midarubiccube/homemade_NIC/自作NICキット説明書.pdf

# 自作NICキット 説明書

## 免責事項

## 部品表

部品番号 | 個数 | 部品名 | 部品概要
C1 | 1 | GRM31BR72J103KW01L | 積層セラミック0.01μF630V
C2,C3 | 2 | GCM1885C2A220JA16D | 積層セラミック22pF50V
C3~C16 | 15 | GCM155R71H104KE02D | 積層セラミック0.1μF50V
D1,D2 | 2 | H5VU25U | TVSダイオード4A 14V（●写真）
J2 | 1 | RJ-056A-1 | RJ45コネクタ
R1, R2 | 2 | RC0603FR-07470RL | 470Ω抵抗
R3~R7 | 5 | RC0603FR-075K1L | 5.1k抵抗
R5,R8-R10 | 4 | RC0603FR-0775RL | 75Ω抵抗
TR1 | 1 | G2436S | パルストランス（●写真）
U1 | 1 | RTL8111H | PCIe-LAN変換IC（実装済み）
U2 | 1 | TPS2216 | 電源スイッチIC（●写真）
Y1 | 1 | X49SM25MSD2SC | 25MHzクリスタル

部品は紛失したときのために実際使う個数より少し多く入れています。

## 部品写真

●TVSダイオード
H5VU25U

●パルストランス
G2436S

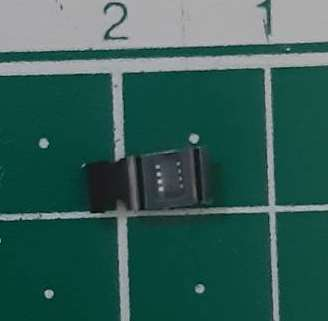
[picture p1: figure]
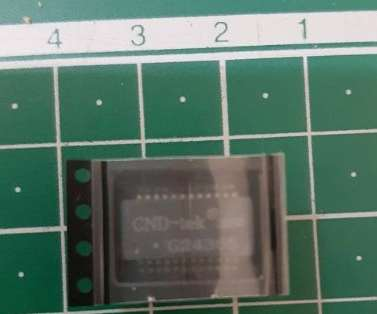
[picture p2: figure]
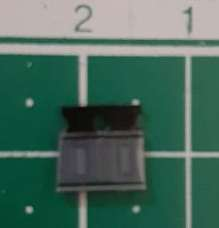
[picture p3: figure]

1

@daimiya

本キットは、趣味の範囲で楽しんでいただく物です。サーバーや重要なシステムなどの、 生命や財産に関わる重要な用途に使用された場合、また、本キットを用いたことにより発 生した損害について如何なる補償も致しかねます。

●電源スイッチIC
TPS2216

## 回路図

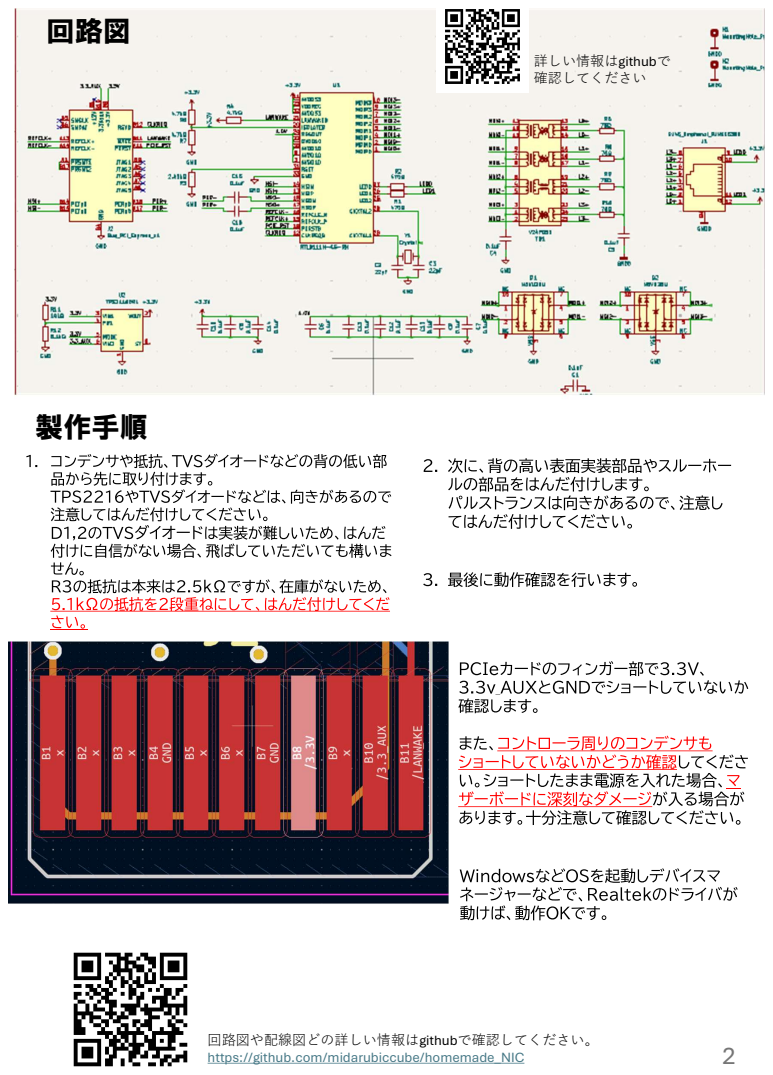
[picture p4: page 2]
製作手順; 詳しい情報はgithubで 確認してください

回路図や配線図どの詳しい情報はgithubで確認してください。
https://github.com/midarubiccube/homemade_NIC
