midarubiccube/homemade_NIC/pcietoETH.kicad_pcb

## KiCad design pcietoETH.kicad_pcb (2025-09-05)

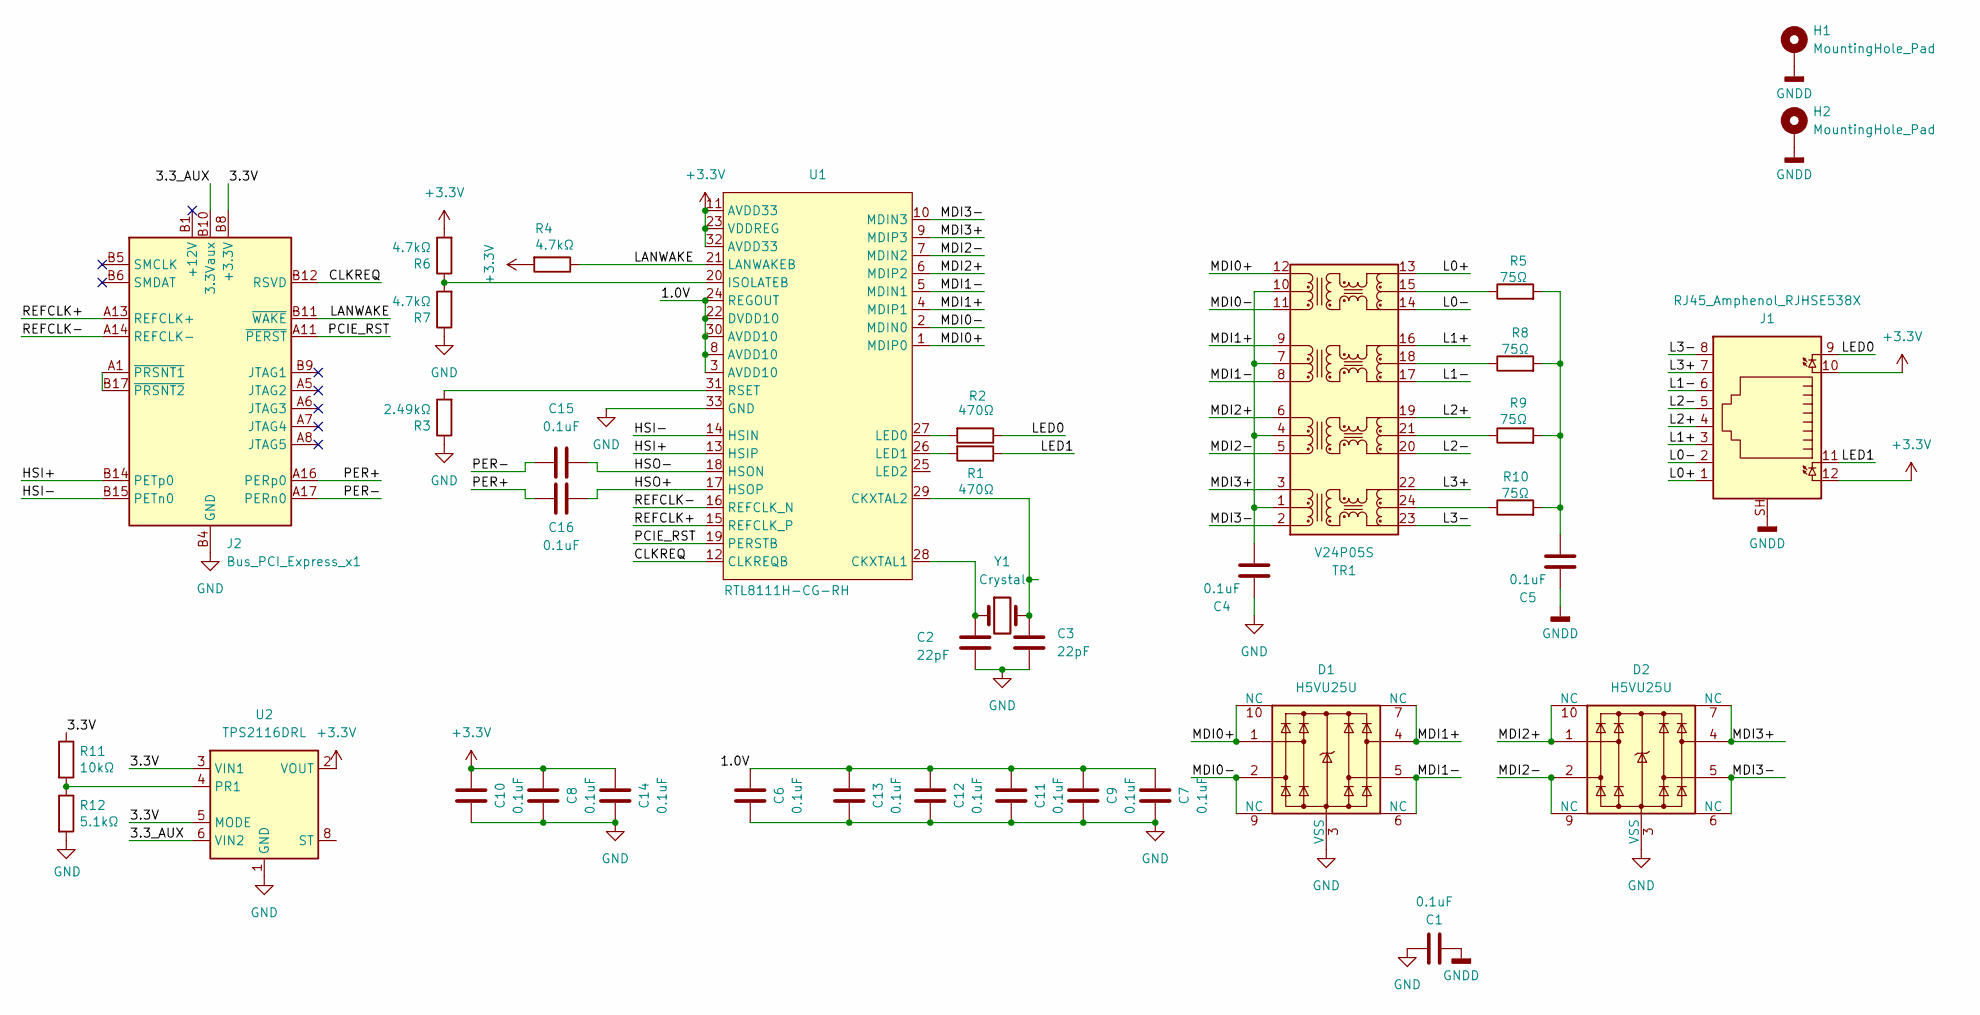
[picture p5: schematic pcietoETH.kicad_sch]

Parts:
C1: 0.1uF; L_1206_3216Metric_Pad1.22x1.90mm_HandSolder
C2, C3: 22pF; C_0603_1608Metric_Pad1.08x0.95mm_HandSolder
C4, C5, C6, C7, C8, C9, C10, C11, C12, C13, C14, C15, C16: 0.1uF; C_0402_1005Metric_Pad0.74x0.62mm_HandSolder
D1, D2: H5VU25U; Diodes_UDFN-10_1.0x2.5mm_P0.5mm
H1, H2: MountingHole_Pad; MountingHole_3.2mm_M3_ISO14580_Pad
J1: RJ45_Amphenol_RJHSE538X; AMPHENOL_RJSBE5381C1
J2: Bus_PCI_Express_x1; BUS_PCIexpress_x1
R1, R2: 470Ω; R_0603_1608Metric_Pad0.98x0.95mm_HandSolder; Part Description Resistor 10K M1005 1% 63mW
R3: 2.49kΩ; R_0603_1608Metric_Pad0.98x0.95mm_HandSolder; Part Description Resistor 10K M1005 1% 63mW
R4, R6, R7: 4.7kΩ; R_0603_1608Metric_Pad0.98x0.95mm_HandSolder; Part Description Resistor 10K M1005 1% 63mW
R5, R8, R9, R10: 75Ω; R_0603_1608Metric_Pad0.98x0.95mm_HandSolder; Part Description Resistor 10K M1005 1% 63mW
R11: 10kΩ; R_0603_1608Metric_Pad0.98x0.95mm_HandSolder; Part Description Resistor 2.2K M1005 1% 63mW
R12: 5.1kΩ; R_0603_1608Metric_Pad0.98x0.95mm_HandSolder; Part Description Resistor 2.2K M1005 1% 63mW
TR1: V24P05S
U1: RTL8111H-CG-RH; QFN40P400X400X90-33N
U2: TPS2116DRL; SOT-583-8
Y1: Crystal; Crystal_SMD_HC49-SD

Connections:
/1.0V: C6.2, C7.2, C9.2, C11.2, C12.2, C13.2, U1.3 (AVDD10), U1.8 (AVDD10), U1.22 (DVDD10), U1.24 (REGOUT), U1.30 (AVDD10)
/3.3_AUX: J2.B10 (3.3Vaux), U2.6 (VIN2)
/CLKREQ: J2.B12 (RSVD), U1.12 (CLKREQB)
/HSI+: J2.B14 (PETp0), U1.13 (HSIP)
/HSI-: J2.B15 (PETn0), U1.14 (HSIN)
/HSO+: C16.2, U1.17 (HSOP)
/HSO-: C15.2, U1.18 (HSON)
/L0+: J1.1, TR1.13 (MX4-)
/L0-: J1.2, TR1.14 (MX4+)
/L1+: J1.3, TR1.16 (MX3-)
/L1-: J1.6, TR1.17 (MX3+)
/L2+: J1.4, TR1.19 (MX2-)
/L2-: J1.5, TR1.20 (MX2+)
/L3+: J1.7, TR1.22 (MX1-)
/L3-: J1.8, TR1.23 (MX1+)
/LANWAKE: J2.B11 (~WAKE), R4.1, U1.21 (LANWAKEB)
/LED0: J1.9, R2.1
/LED1: J1.11, R1.1
/MDI0+: D1.1, D1.10 (NC), TR1.12 (TD4-), U1.1 (MDIP0)
/MDI0-: D1.2, D1.9 (NC), TR1.11 (TD4+), U1.2 (MDIN0)
/MDI1+: D1.4, D1.7 (NC), TR1.9 (TD3-), U1.4 (MDIP1)
/MDI1-: D1.5, D1.6 (NC), TR1.8 (TD3+), U1.5 (MDIN1)
/MDI2+: D2.1, D2.10 (NC), TR1.6 (TD2-), U1.6 (MDIP2)
/MDI2-: D2.2, D2.9 (NC), TR1.5 (TD2+), U1.7 (MDIN2)
/MDI3+: D2.4, D2.7 (NC), TR1.3 (TD1-), U1.9 (MDIP3)
/MDI3-: D2.5, D2.6 (NC), TR1.2 (TD1+), U1.10 (MDIN3)
/PCIE_RST: J2.A11 (~PERST), U1.19 (PERSTB)
/PER+: C16.1, J2.A16 (PERp0)
/PER-: C15.1, J2.A17 (PERn0)
/REFCLK+: J2.A13 (REFCLK+), U1.15 (REFCLK_P)
/REFCLK-: J2.A14 (REFCLK-), U1.16 (REFCLK_N)
GND: C1.2, C2.2, C3.2, C4.1, C6.1, C7.1, C8.1, C9.1, C10.1, C11.1, C12.1, C13.1, C14.1, D1.3 (VSS), D1.8 (VSS), D2.3 (VSS), D2.8 (VSS), J2.A4 (GND), J2.A12 (GND), J2.A15 (GND), J2.A18 (GND), J2.B4 (GND), J2.B7 (GND), J2.B13 (GND), J2.B16 (GND), J2.B18 (GND), R3.1, R7.1, R12.2, U1.33 (GND), U2.1 (GND)
GNDD: C1.1, C5.1, H1.1, H2.1, J1.SH
unnamed: C5.2, R5.2, R8.2, R9.2, R10.2
unnamed: J2.A1 (~PRSNT1), J2.B17 (~PRSNT2)
unnamed: R10.1, TR1.24 (MCT1)
unnamed: R9.1, TR1.21 (MCT2)
unnamed: R8.1, TR1.18 (MCT3)
unnamed: R5.1, TR1.15 (MCT4)
unnamed: C4.2, TR1.1 (TCT1), TR1.4 (TCT2), TR1.7 (TCT3), TR1.10 (TCT4)
unnamed: C2.1, U1.28 (CKXTAL1), Y1.1
unnamed: C3.1, U1.29 (CKXTAL2), Y1.2
unnamed: R6.1, R7.2, U1.20 (ISOLATEB)
unnamed: R2.2, U1.27 (LED0)
unnamed: R1.2, U1.26 (LED1)
unnamed: R3.2, U1.31 (RSET)
unnamed: R11.2, R12.1, U2.4 (PR1)

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
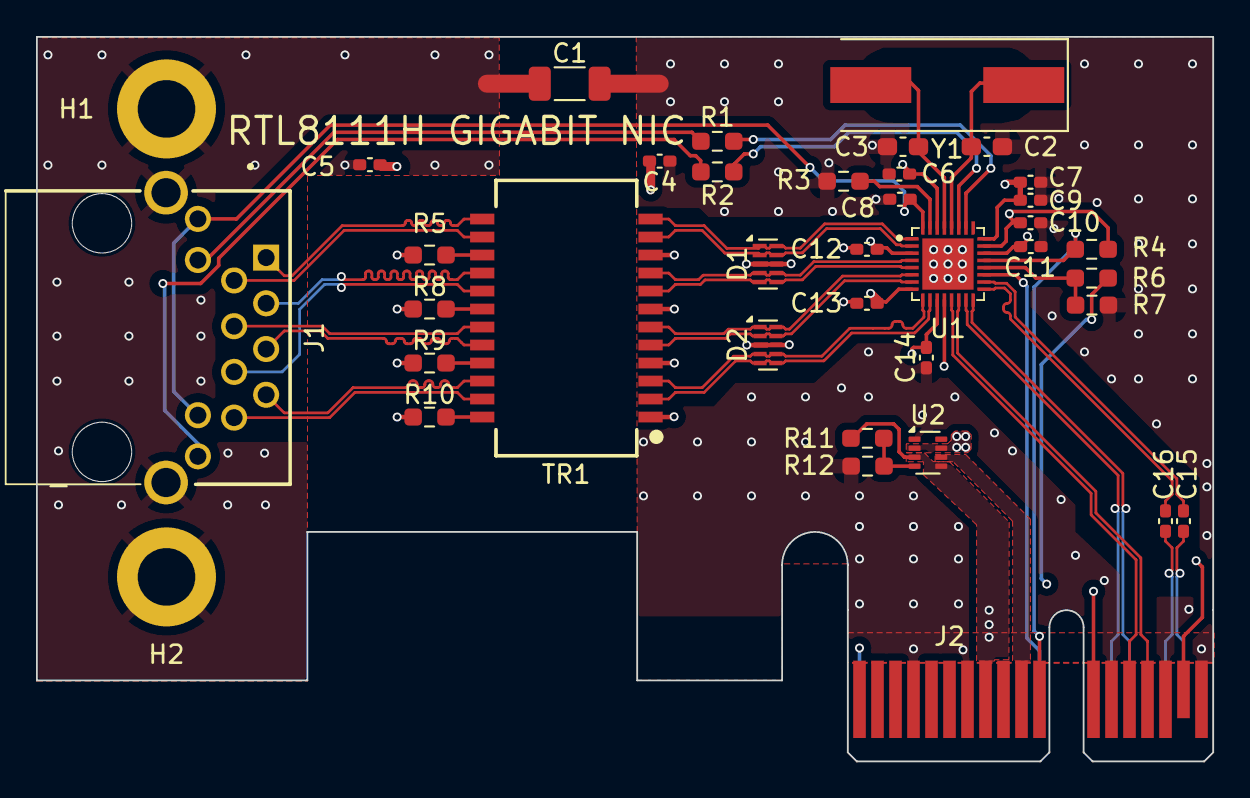
[picture p6: board pcietoETH.kicad_pcb from above]

Board: 4 copper layers, 65.4 x 40.2 mm, 38 parts (0 on the bottom side), 49 nets.
